Lachcim/szopinski-emisy/README.md

# szopinski-emisy

My Microcontroller Systems project for Mr Urbański, MSc, soon-to-be PhD. The project is a paper tape reader and has been completed using real hardware. The repository includes the source code, the KiCad files and the documentation. Check the releases tab for the compiled report.

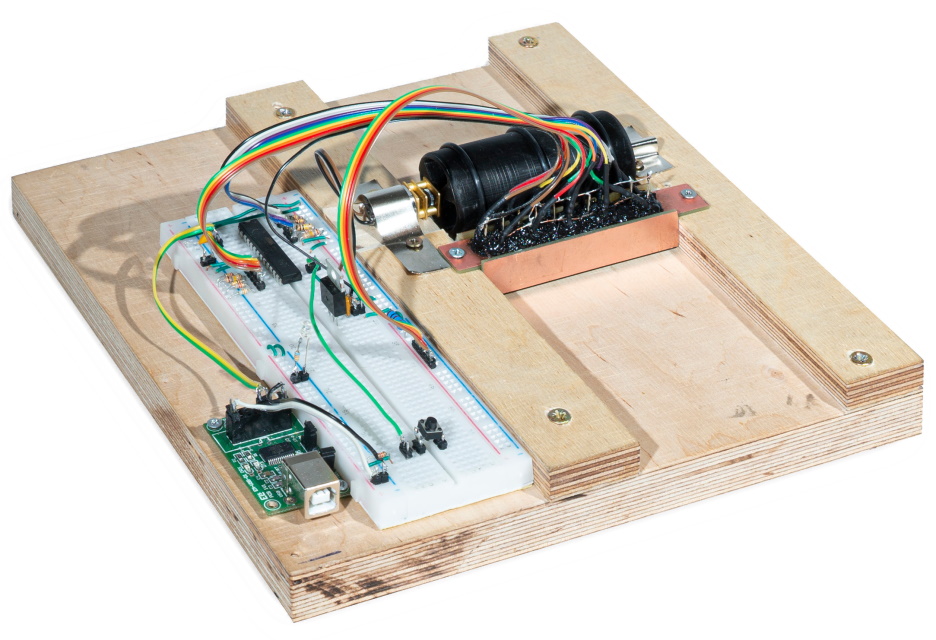
[picture p1: report/img/device.jpg]
