Lachcim/szopinski-emisy/report/img/horizontal.pdf

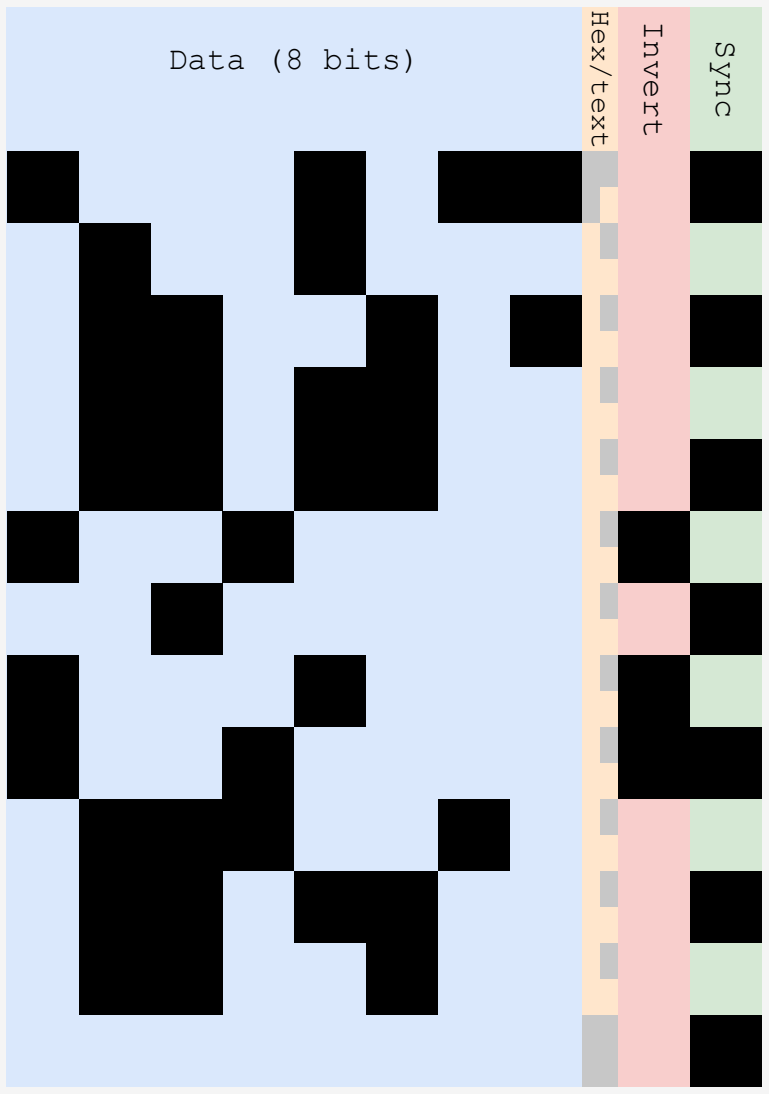
[picture p7: figure]
Data (8 bits); Hex/text; Invert; Sync
