Lachcim/szopinski-emisy/report/img/vertical.pdf

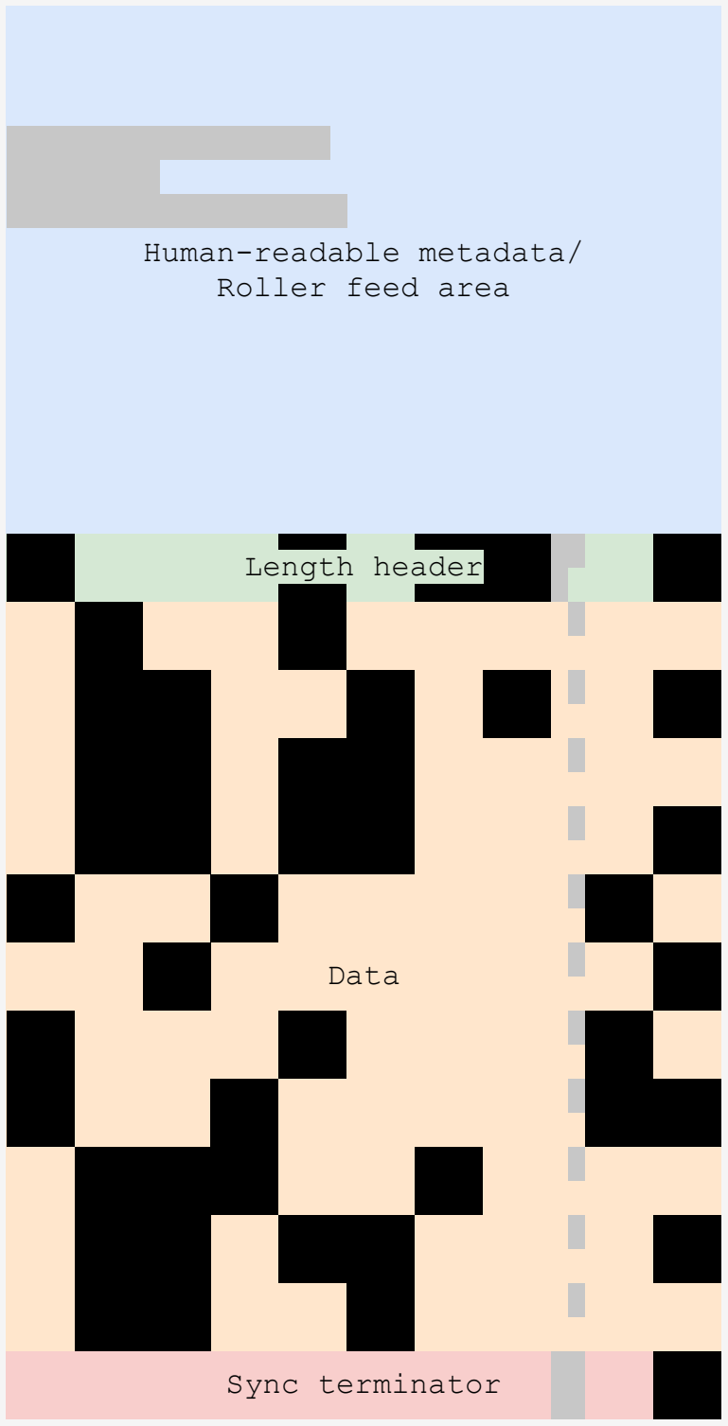
[picture p8: figure]
Human-readable metadata/ Roller feed area; Length header; Data; Sync terminator
