Lachcim/szopinski-emisy/report/img/async.pdf

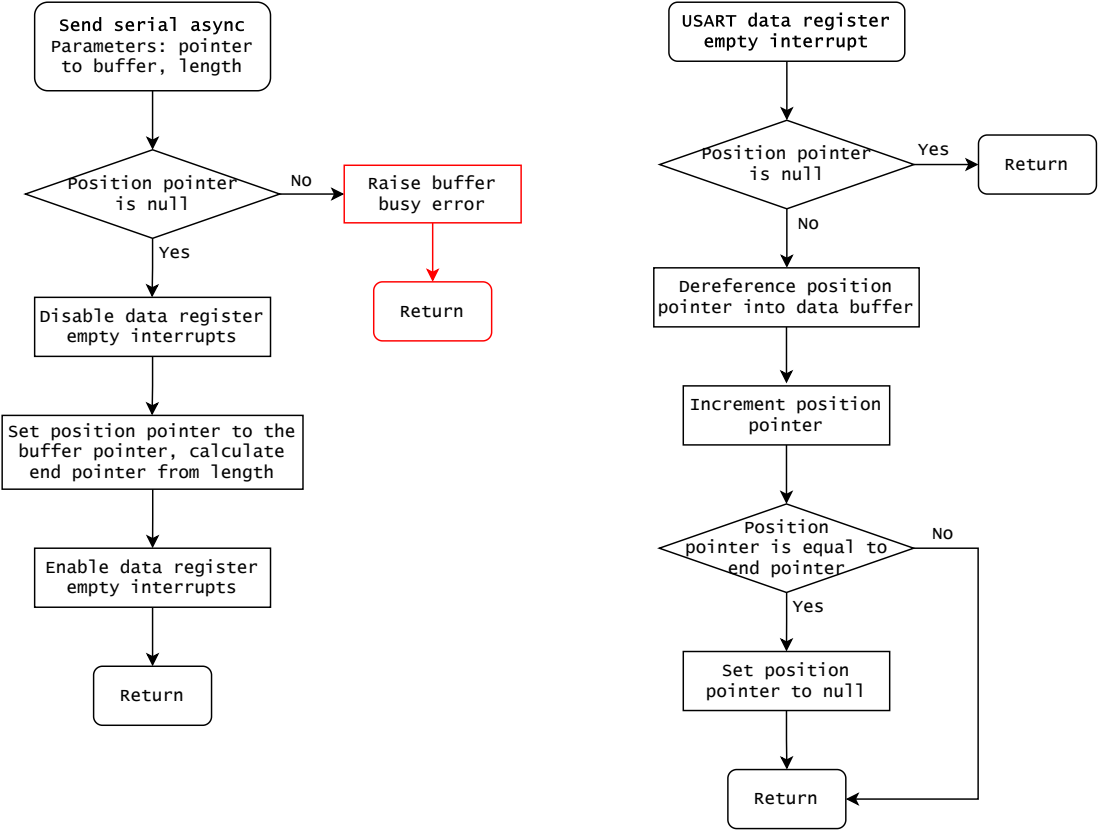
[picture p9: page 1]
Position pointer is null; Raise buffer busy error; Return; Yes; Position pointer; is null; Increment position pointer; Position; pointer is equal; end pointer

Send serial async
Parameters: pointer
to buffer, length

USART data register
empty interrupt

Dereference position
pointer into data buffer

Disable data register
empty interrupts

Set position pointer to the
buffer pointer, calculate
end pointer from length

Enable data register

Set position
pointer to null
