Lachcim/szopinski-emisy/report/img/estop.pdf

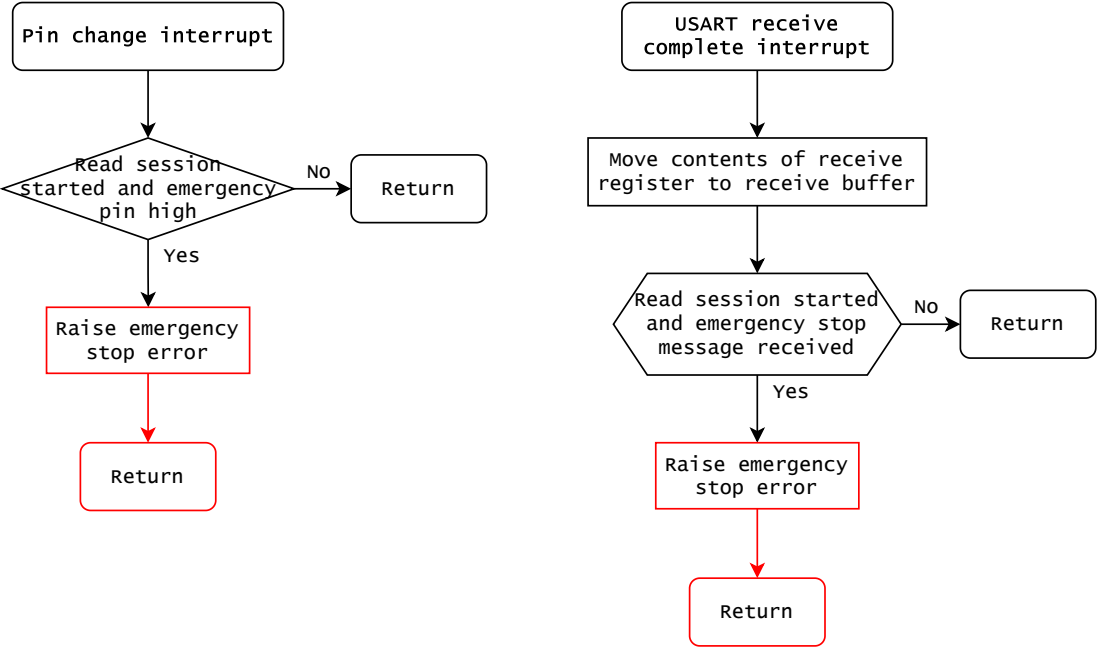
[picture p10: page 1]
pin high; Return; Raise emergency stop error; USART receive complete interrupt; Yes

Pin change interrupt

Read session
started and emergency

Move contents of receive
register to receive buffer

Read session started
and emergency stop
message received
