Lachcim/szopinski-emisy/report/img/init.pdf

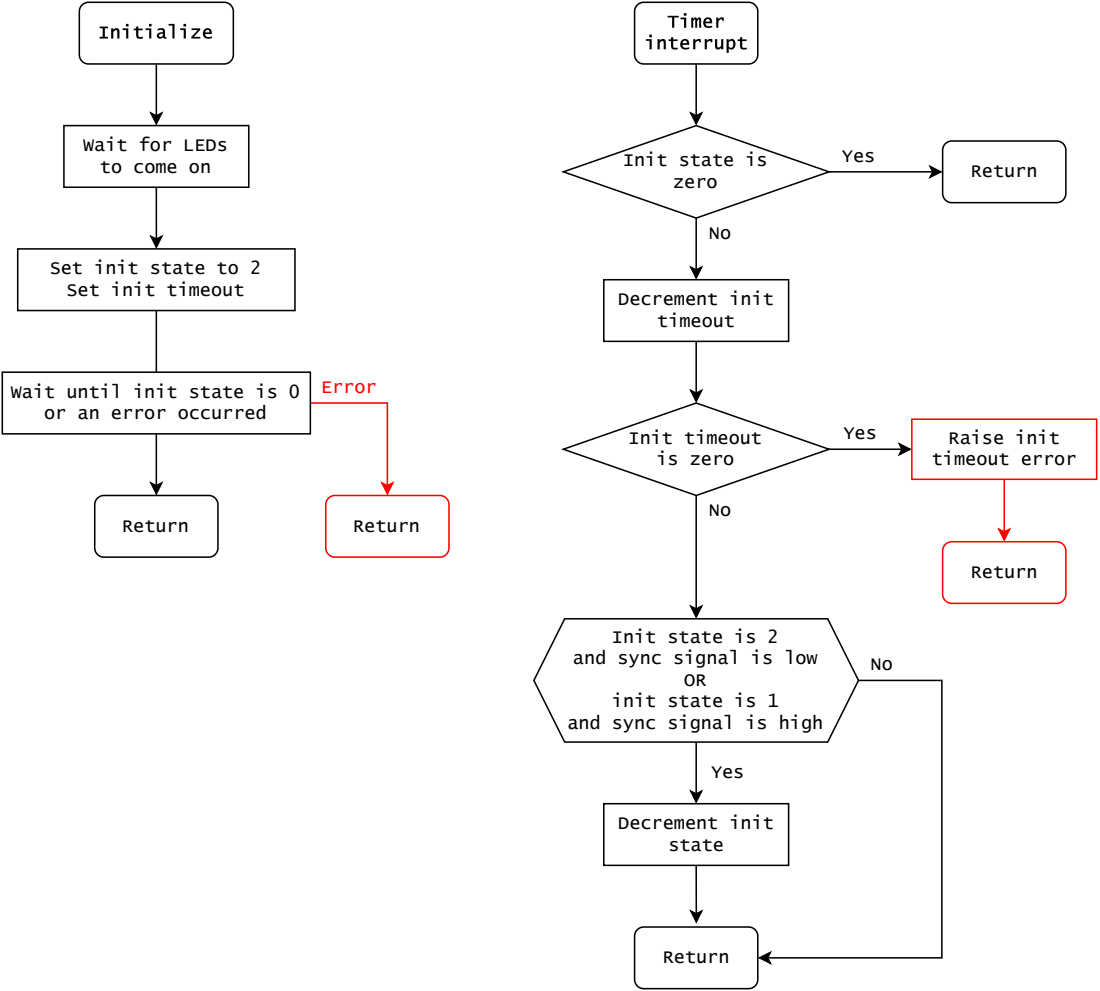
[picture p11: page 1]
Initialize; Return; Error; Timer interrupt; Yes; Decrement init timeout; Raise init timeout error; Init timeout is zero; init state is; and sync signal is; high; Decrement init state

Wait for LEDs
to come on

Init state is
zero

Set init state to 2
Set init timeout

Wait until init state is 0
or an error occurred

Init state is 2
and sync signal is low
