Lachcim/szopinski-emisy/report/img/main.pdf

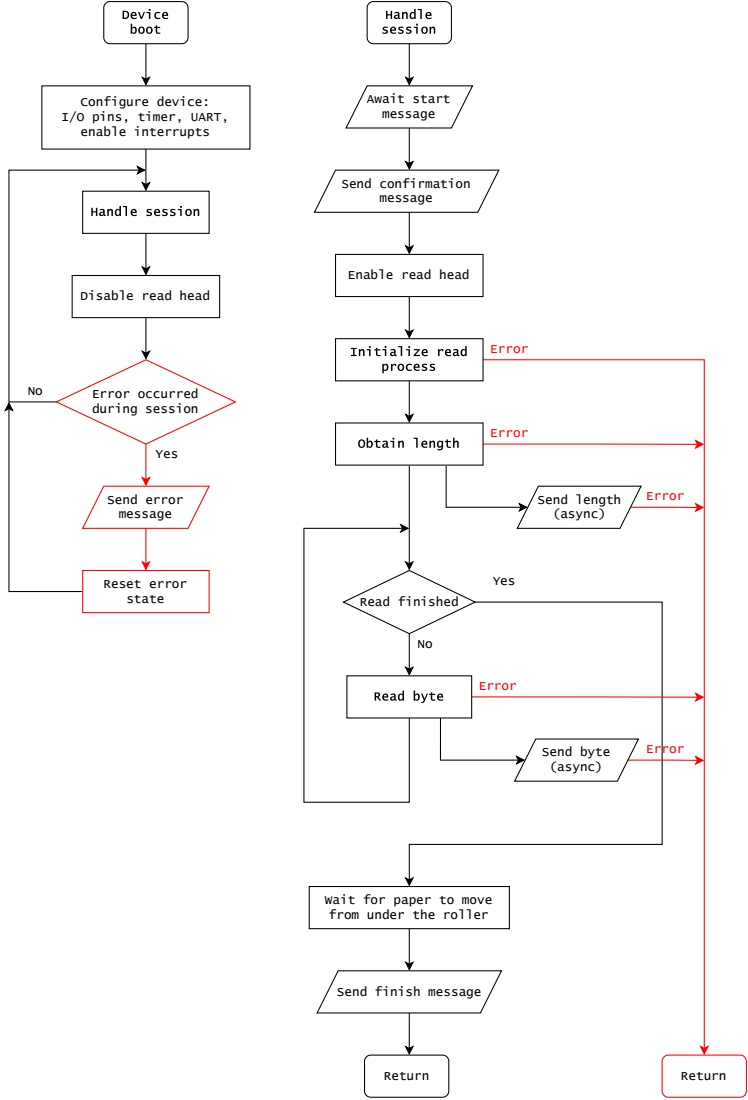
[picture p12: page 1]
Device boot; Handle session; Error occurred during session; Yes; Send error message; Reset error state; Await start message; Send confirmation message; Initialize read; process; Obtain length; Send length (async); Read finished; Read byte; Send byte (async); Return; Error

Configure device:
I/O pins, timer, UART,
enable interrupts

Enable read head

Disable read head

Wait for paper to move
from under the roller

Send finish message
