Lachcim/szopinski-emisy/report/img/read.pdf

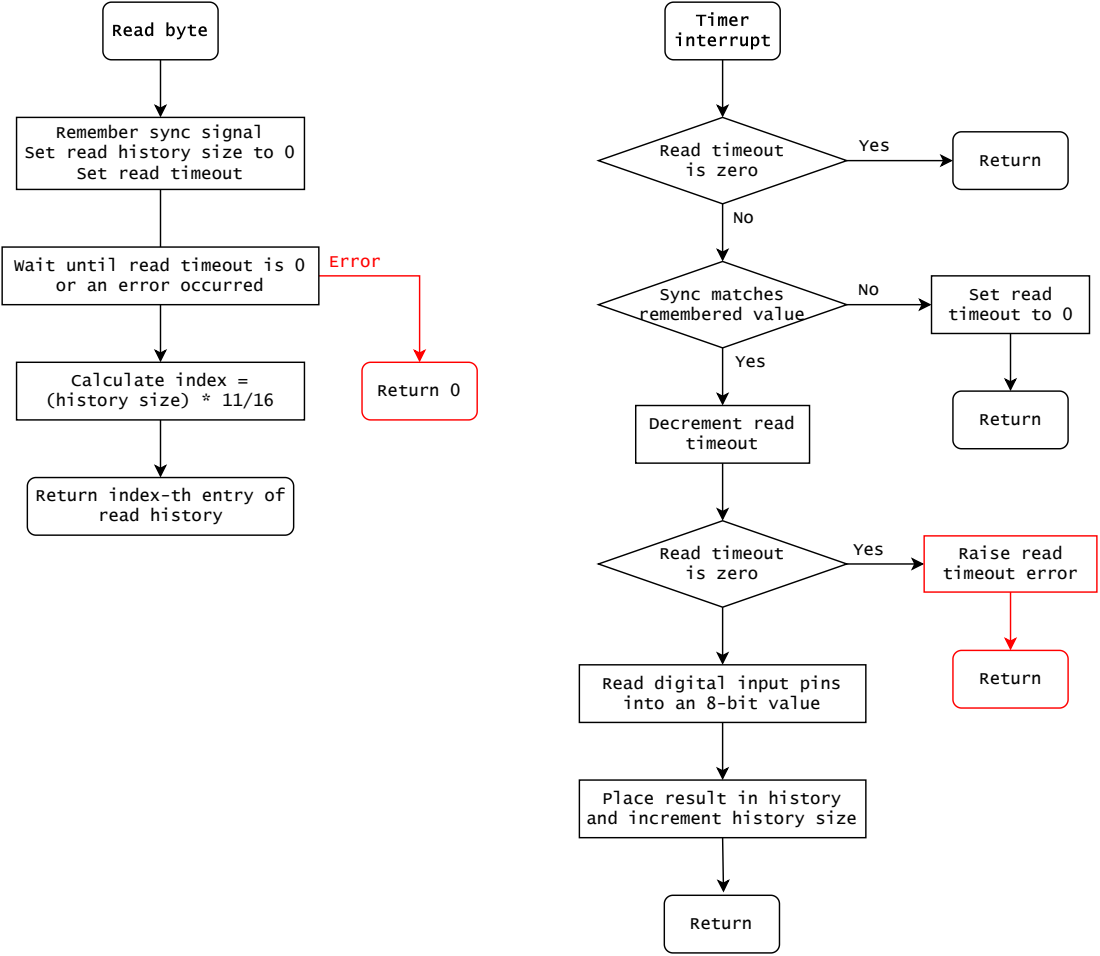
[picture p13: page 1]
Read byte; Error; read history; Timer interrupt; Read timeout; is zero; Return; Yes; Sync matches remembered value; Set read timeout to 0; Decrement read timeout; Read timeout is zero; Raise read timeout error; Read digital input pins

Remember sync signal
Set read history size to 0

Set read timeout

Wait until read timeout is 0
or an error occurred

Return 0 Calculate index =
(history size) * 11/16

Return index-th entry of

into an 8-bit value

Place result in history
and increment history size
