Lachcim/szopinski-emisy/report/img/schematic.pdf

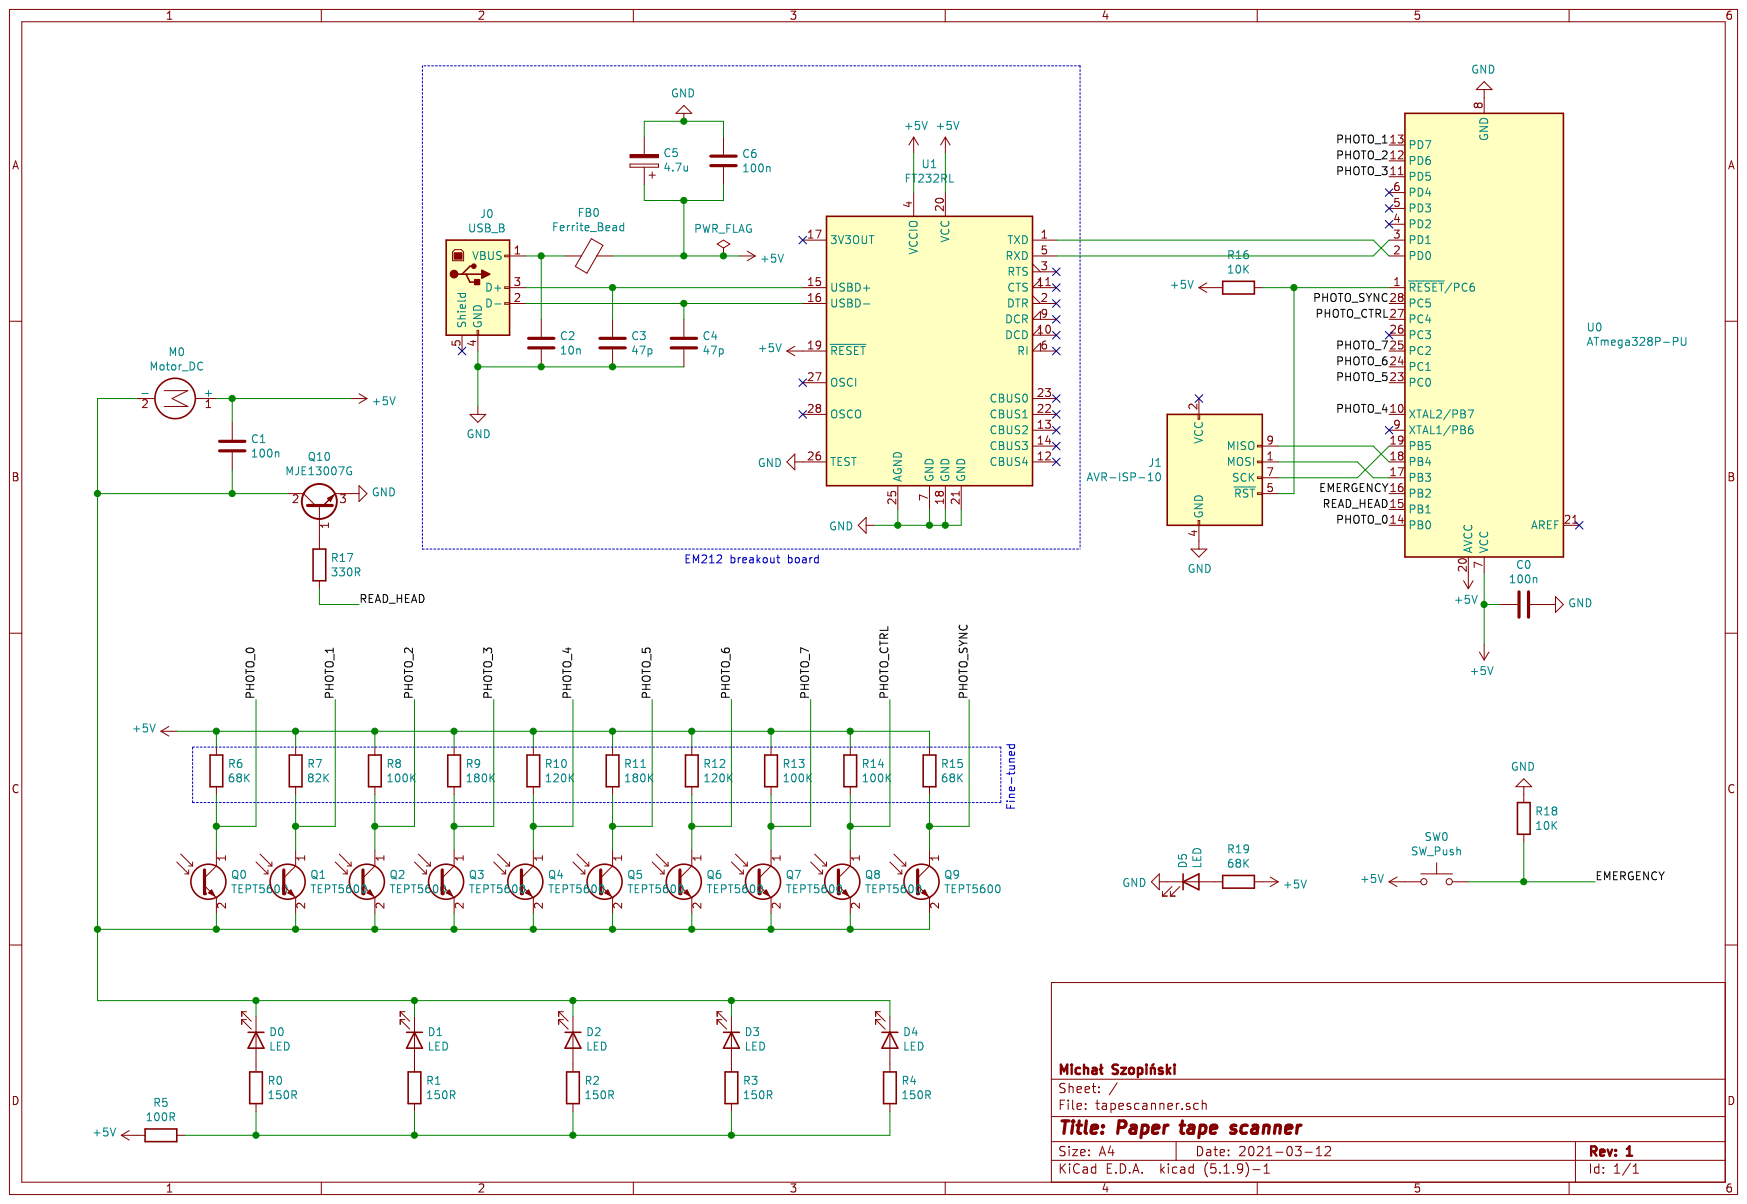
[picture p14: page 1]
