Lachcim/szopinski-emisy/report/img/sync.pdf

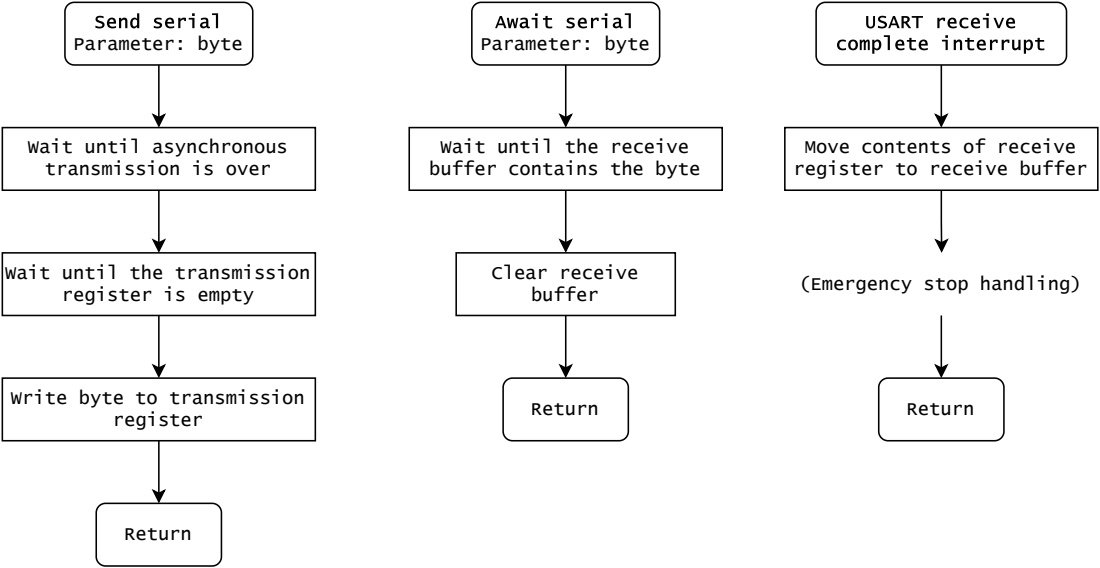
[picture p15: page 1]
Send serial Parameter: byte; register; Return; Await serial Parameter: byte; Clear receive buffer; USART receive complete interrupt

Wait until asynchronous
transmission is over

Wait until the receive
buffer contains the byte

Move contents of receive
register to receive buffer

Wait until the transmission

register is empty

(Emergency stop handling)

Write byte to transmission
