Lachcim/szopinski-emisy/tapescanner/tapescanner.sch

## KiCad design tapescanner/tapescanner.sch (2021-04-02)

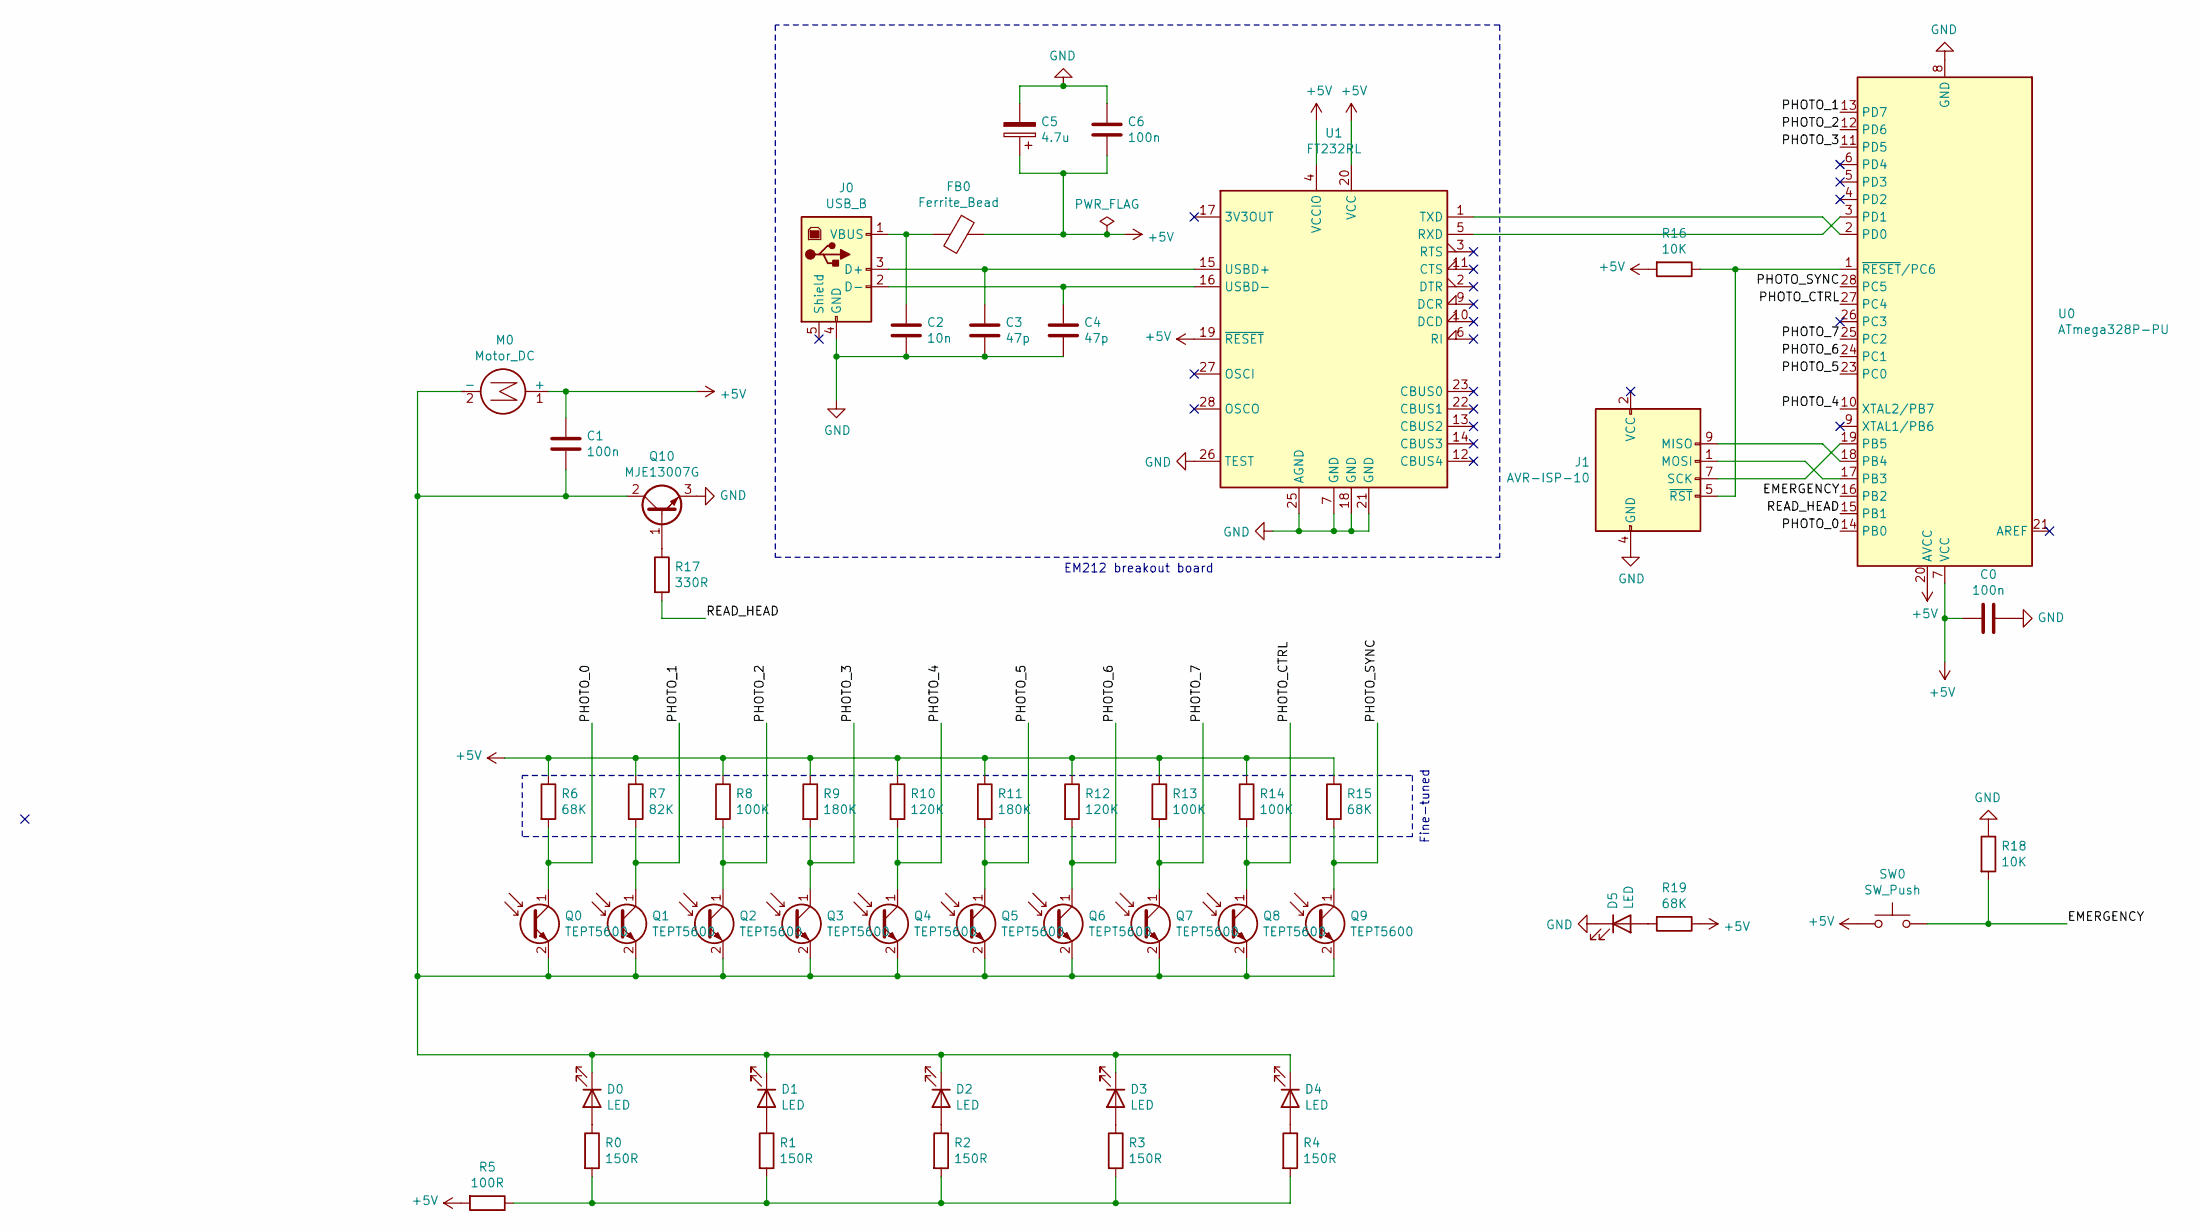
[picture p16: schematic tapescanner.sch]

Parts:
C0, C1, C6: 100n
C2: 10n
C3, C4: 47p
C5: 4.7u
D0, D1, D2, D3, D4, D5: LED
FB0: Ferrite_Bead
J0: USB_B
J1: AVR-ISP-10
M0: Motor_DC
Q0, Q1, Q2, Q3, Q4, Q5, Q6, Q7, Q8, Q9: TEPT5600; LED_D3.0mm_Clear
Q10: MJE13007G; TO-220-3_Vertical
R0, R1, R2, R3, R4: 150R
R5: 100R
R6, R15, R19: 68K
R7: 82K
R8, R13, R14: 100K
R9, R11: 180K
R10, R12: 120K
R16, R18: 10K
R17: 330R
SW0: SW_Push
U0: ATmega328P-PU; DIP-28_W7.62mm
U1: FT232RL; SSOP-28_5.3x10.2mm_P0.65mm

Connections:
+5V: C0.2, C1.1, C5.1, C6.2, FB0.1, M0.1 (+), R5.2, R6.1, R7.1, R8.1, R9.1, R10.1, R11.1, R12.1, R13.1, R14.1, R15.1, R16.2, R19.1, SW0.1, U0.7 (VCC), U0.20 (AVCC), U1.4 (VCCIO), U1.19 (~RESET~), U1.20 (VCC)
EMERGENCY: R18.2, SW0.2, U0.16 (PB2)
GND: C0.1, C2.2, C3.2, C4.2, C5.2, C6.1, D5.1 (K), J0.4 (GND), J1.4 (GND), J1.6 (GND), J1.8 (GND), J1.10 (GND), Q10.3 (E), R18.1, U0.8 (GND), U0.22 (GND), U1.7 (GND), U1.18 (GND), U1.21 (GND), U1.25 (AGND), U1.26 (TEST)
unnamed: C1.2, D0.1 (K), D1.1 (K), D2.1 (K), D3.1 (K), D4.1 (K), M0.2 (-), Q0.2 (E), Q1.2 (E), Q2.2 (E), Q3.2 (E), Q4.2 (E), Q5.2 (E), Q6.2 (E), Q7.2 (E), Q8.2 (E), Q9.2 (E), Q10.2 (C)
unnamed: C2.1, FB0.2, J0.1 (VBUS)
unnamed: C3.1, J0.3 (D+), U1.15 (USBD+)
unnamed: C4.1, J0.2 (D-), U1.16 (USBD-)
unnamed: D0.2 (A), R0.1
unnamed: D1.2 (A), R1.1
unnamed: D2.2 (A), R2.1
unnamed: D3.2 (A), R3.1
unnamed: D4.2 (A), R4.1
unnamed: D5.2 (A), R19.2
unnamed: J1.1 (MOSI), U0.17 (PB3)
unnamed: J1.5 (~RST), R16.1, U0.1 (~RESET~/PC6)
unnamed: J1.7 (SCK), U0.19 (PB5)
unnamed: J1.9 (MISO), U0.18 (PB4)
unnamed: Q10.1 (B), R17.1
unnamed: R0.2, R1.2, R2.2, R3.2, R4.2, R5.1
unnamed: U0.2 (PD0), U1.1 (TXD)
unnamed: U0.3 (PD1), U1.5 (RXD)
PHOTO_0: Q0.1 (C), R6.2, U0.14 (PB0)
PHOTO_1: Q1.1 (C), R7.2, U0.13 (PD7)
PHOTO_2: Q2.1 (C), R8.2, U0.12 (PD6)
PHOTO_3: Q3.1 (C), R9.2, U0.11 (PD5)
PHOTO_4: Q4.1 (C), R10.2, U0.10 (XTAL2/PB7)
PHOTO_5: Q5.1 (C), R11.2, U0.23 (PC0)
PHOTO_6: Q6.1 (C), R12.2, U0.24 (PC1)
PHOTO_7: Q7.1 (C), R13.2, U0.25 (PC2)
PHOTO_CTRL: Q8.1 (C), R14.2, U0.27 (PC4)
PHOTO_SYNC: Q9.1 (C), R15.2, U0.28 (PC5)
READ_HEAD: R17.2, U0.15 (PB1)

Notes on the sheet:
Fine-tuned
EM212 breakout board
