Lachcim/szopinski-emisy/(commit log)

2021-02-26 Add newlines to error messages
    [main.c]
2021-03-12 Add KiCad project with read head
    [tapescanner.sch]
2021-03-12 Reduce the number of LEDs
    [tapescanner.sch]
2021-03-13 Fix bug when printing 0xFF
    [write.c]
2021-03-16 Add the microcontroller
    [tapescanner.sch]
2021-03-17 Fine-tune resistors
    [tapescanner.sch]
2021-03-17 Add bypass capacitor
    [tapescanner.sch]
2021-03-18 Move timer ISR to op
2021-03-19 Burden IO routines with opening devices
2021-03-24 Add long and short timeouts
    [read.c, read_win32.c, thermfile.h]
2021-03-24 Toggle power to read head
2021-03-24 Add FT232RL
    [tapescanner.sch]
2021-03-24 Add motor and power switching circuit
    [tapescanner.sch]
2021-03-25 Include EM212 board in schematic
    [tapescanner.sch]
2021-03-25 Add missing power flag
    [tapescanner.sch]
2021-03-25 Fix RKM codes
    [tapescanner.sch]
2021-03-26 Add missing error handling
    [main.c]
2021-03-26 Fix motor capacitor
    [tapescanner.sch]
2021-03-26 Add power LED
    [tapescanner.sch]
2021-03-30 Readjust resistors
    [tapescanner.sch]
2021-04-02 Adjust connections
    [tapescanner.sch]
